bit7io/openpnp-controller/README.md

### Open source PNP controller
Generic controller for a PNP machine with 2 heads, needle/drag tape advance, L&R motors for tape peelers, 1 vibrating feeder, 1 air pump, 2 Y steppers, up looking camera on UART, down looking camera on UART, display on UART and SD card for input.
