bit7io/openpnp-controller/MCU.kicad_sch

## KiCad design MCU.kicad_sch (2024-02-26)

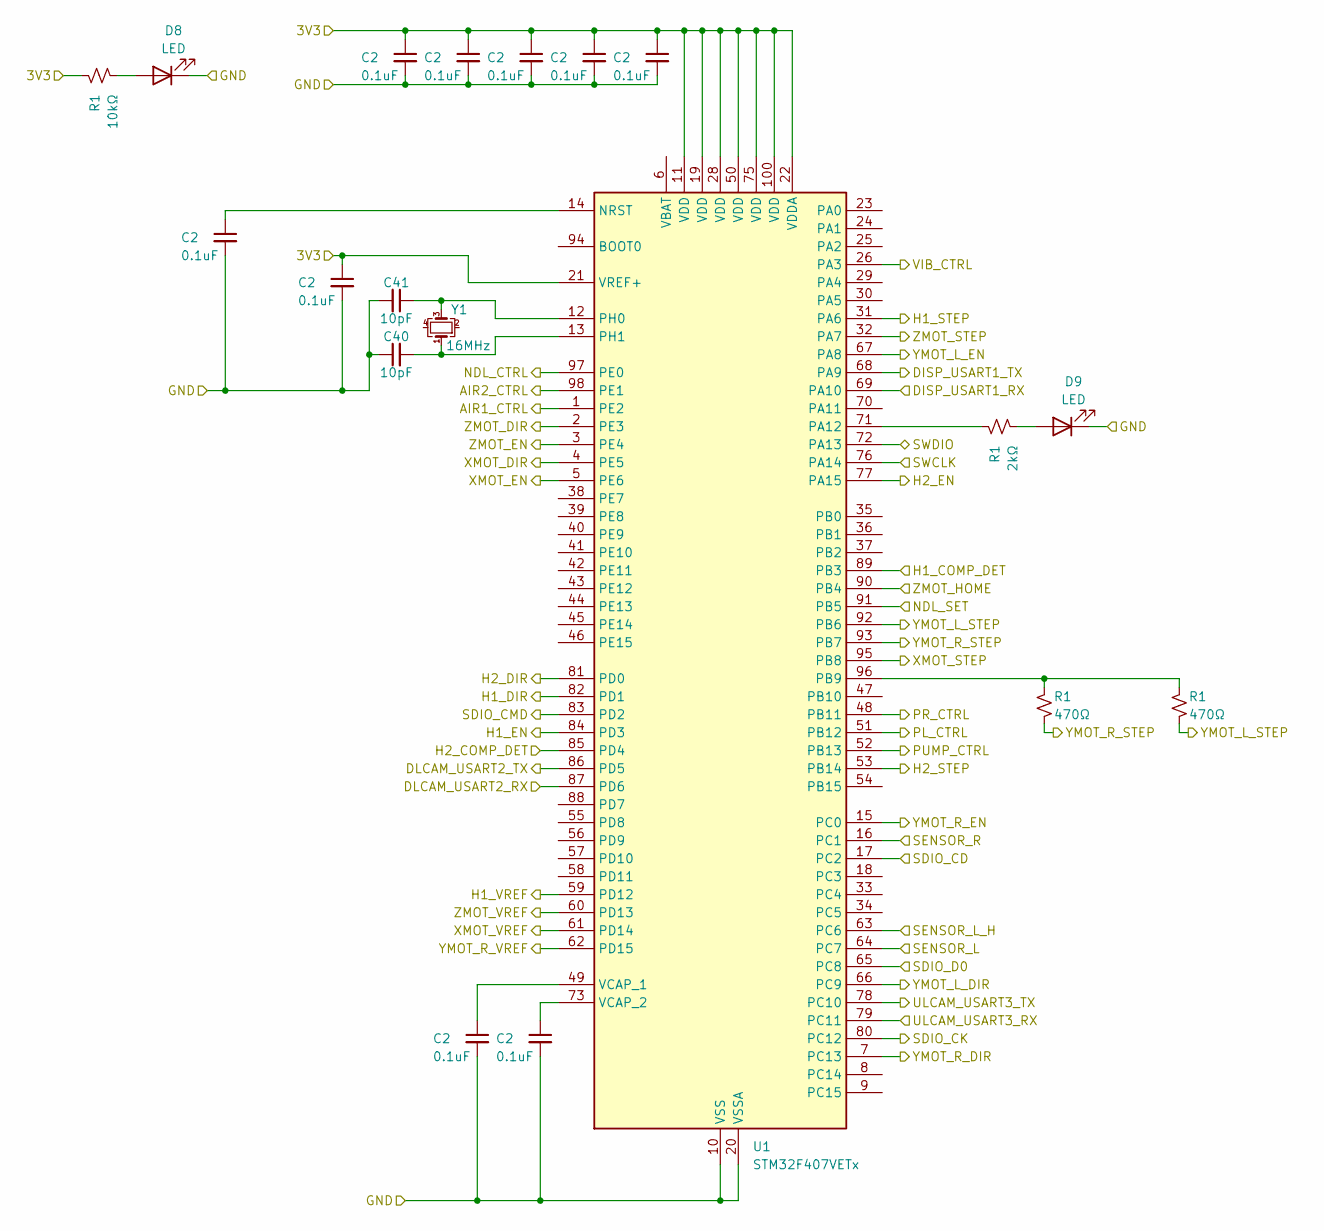
[picture p1: schematic MCU.kicad_sch]

Parts:
C2: 0.1uF
C40, C41: 10pF
D8, D9: LED
R1: 470Ω
U1: STM32F407VETx; LQFP-100_14x14mm_P0.5mm; MPN STM32F407VET6
Y1: 16MHz; MPN RH100-16.000-8-2020-TR

Connections:
3V3: C2.1, R1.1, U1.11 (VDD), U1.19 (VDD), U1.21 (VREF+), U1.22 (VDDA), U1.28 (VDD), U1.50 (VDD), U1.75 (VDD), U1.100 (VDD)
AIR1_CTRL: U1.1 (PE2)
AIR2_CTRL: U1.98 (PE1)
DISP_USART1_RX: U1.69 (PA10)
DISP_USART1_TX: U1.68 (PA9)
DLCAM_USART2_RX: U1.87 (PD6)
DLCAM_USART2_TX: U1.86 (PD5)
GND: C2.2, C40.1, C41.2, D8.1 (K), D9.1 (K), U1.10 (VSS), U1.20 (VSSA), U1.27 (VSS), U1.74 (VSS), U1.99 (VSS)
H1_COMP_DET: U1.89 (PB3)
H1_DIR: U1.82 (PD1)
H1_EN: U1.84 (PD3)
H1_STEP: U1.31 (PA6)
H1_VREF: U1.59 (PD12)
H2_COMP_DET: U1.85 (PD4)
H2_DIR: U1.81 (PD0)
H2_EN: U1.77 (PA15)
H2_STEP: U1.53 (PB14)
NDL_CTRL: U1.97 (PE0)
NDL_SET: U1.91 (PB5)
unnamed: C2.1, U1.14 (NRST), U1.49 (VCAP_1), U1.73 (VCAP_2)
unnamed: C40.2, U1.13 (PH1), Y1.1
unnamed: C41.1, U1.12 (PH0), Y1.3
unnamed: D8.2 (A), R1.2
unnamed: D9.2 (A), R1.2
unnamed: R1.1, U1.71 (PA12)
unnamed: R1.2, U1.96 (PB9)
PL_CTRL: U1.51 (PB12)
PR_CTRL: U1.48 (PB11)
PUMP_CTRL: U1.52 (PB13)
SDIO_CD: U1.17 (PC2)
SDIO_CK: U1.80 (PC12)
SDIO_CMD: U1.83 (PD2)
SDIO_D0: U1.65 (PC8)
SENSOR_L: U1.64 (PC7)
SENSOR_L_H: U1.63 (PC6)
SENSOR_R: U1.16 (PC1)
SWCLK: U1.76 (PA14)
SWDIO: U1.72 (PA13)
ULCAM_USART3_RX: U1.79 (PC11)
ULCAM_USART3_TX: U1.78 (PC10)
VIB_CTRL: U1.26 (PA3)
XMOT_DIR: U1.4 (PE5)
XMOT_EN: U1.5 (PE6)
XMOT_STEP: U1.95 (PB8)
XMOT_VREF: U1.61 (PD14)
YMOT_L_DIR: U1.66 (PC9)
YMOT_L_EN: U1.67 (PA8)
YMOT_L_STEP: R1.1, U1.92 (PB6)
YMOT_R_DIR: U1.7 (PC13)
YMOT_R_EN: U1.15 (PC0)
YMOT_R_STEP: R1.1, U1.93 (PB7)
YMOT_R_VREF: U1.62 (PD15)
ZMOT_DIR: U1.2 (PE3)
ZMOT_EN: U1.3 (PE4)
ZMOT_HOME: U1.90 (PB4)
ZMOT_STEP: U1.32 (PA7)
ZMOT_VREF: U1.60 (PD13)
