bit7io/openpnp-controller/Motors.kicad_sch

## KiCad design Motors.kicad_sch (2024-02-26)

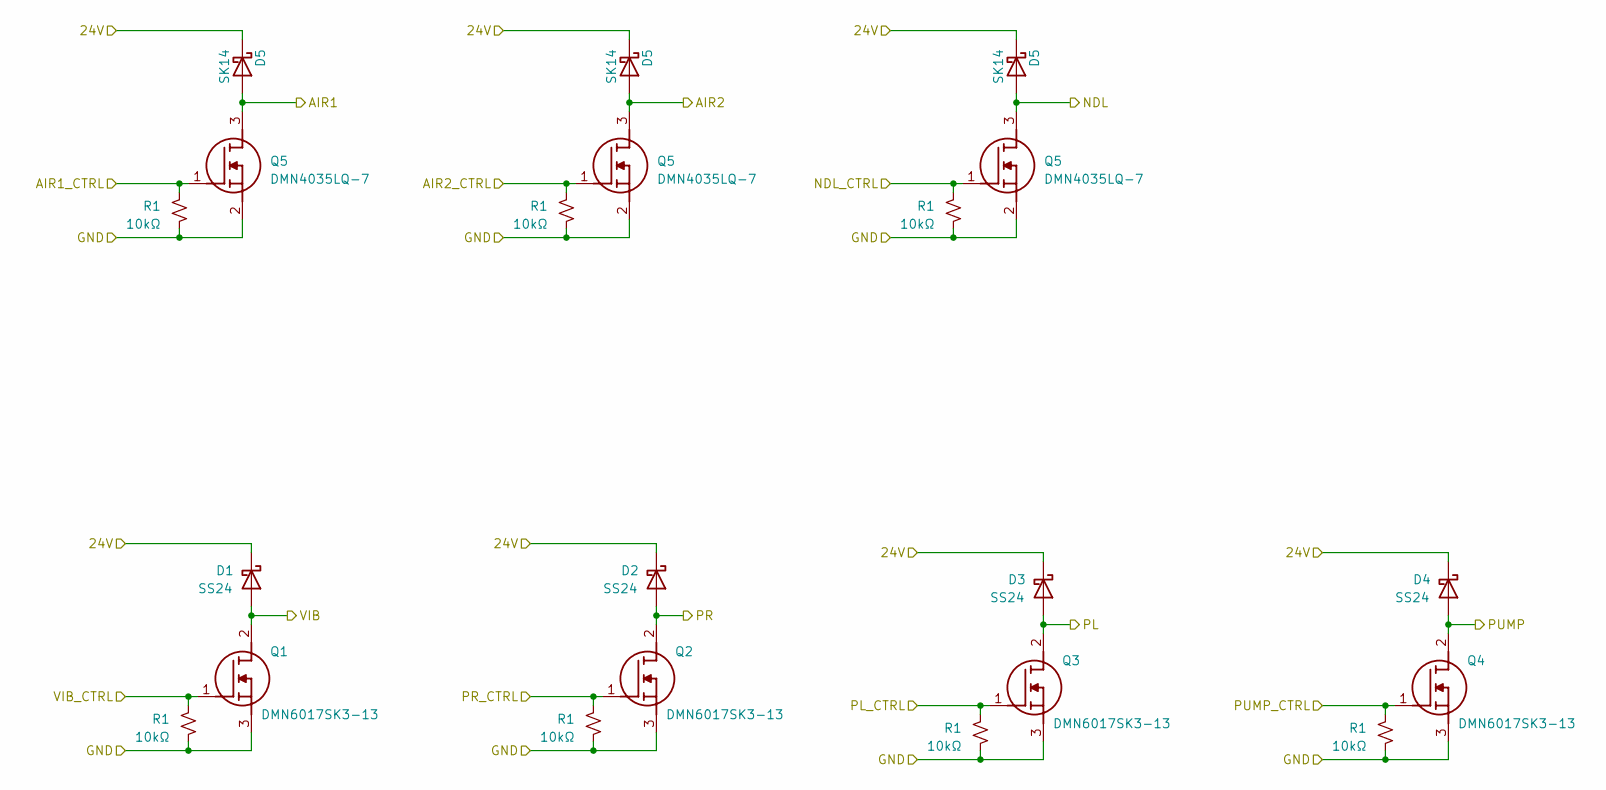
[picture p2: schematic Motors.kicad_sch]

Parts:
D1, D2, D3, D4: SS24
D5: SK14
Q1, Q2, Q3, Q4: DMN6017SK3-13; DMN6017SK313; Mouser Part Number 621-DMN6017SK3-13
Q5: DMN4035LQ-7; SOT96P240X110-3N; Mouser Part Number 621-DMN4035LQ-7
R1: 10kΩ

Connections:
24V: D1.1 (K), D2.1 (K), D3.1 (K), D4.1 (K), D5.1 (K)
AIR1: D5.2 (A), Q5.3 (D)
AIR1_CTRL: Q5.1 (G), R1.1
AIR2: D5.2 (A), Q5.3 (D)
AIR2_CTRL: Q5.1 (G), R1.1
GND: Q1.3 (S), Q2.3 (S), Q3.3 (S), Q4.3 (S), Q5.2 (S), R1.2
NDL: D5.2 (A), Q5.3 (D)
NDL_CTRL: Q5.1 (G), R1.1
PL: D3.2 (A), Q3.2 (D)
PL_CTRL: Q3.1 (G), R1.1
PR: D2.2 (A), Q2.2 (D)
PR_CTRL: Q2.1 (G), R1.1
PUMP: D4.2 (A), Q4.2 (D)
PUMP_CTRL: Q4.1 (G), R1.1
VIB: D1.2 (A), Q1.2 (D)
VIB_CTRL: Q1.1 (G), R1.1
