bit7io/openpnp-controller/Power.kicad_sch

## KiCad design Power.kicad_sch (2024-02-26)

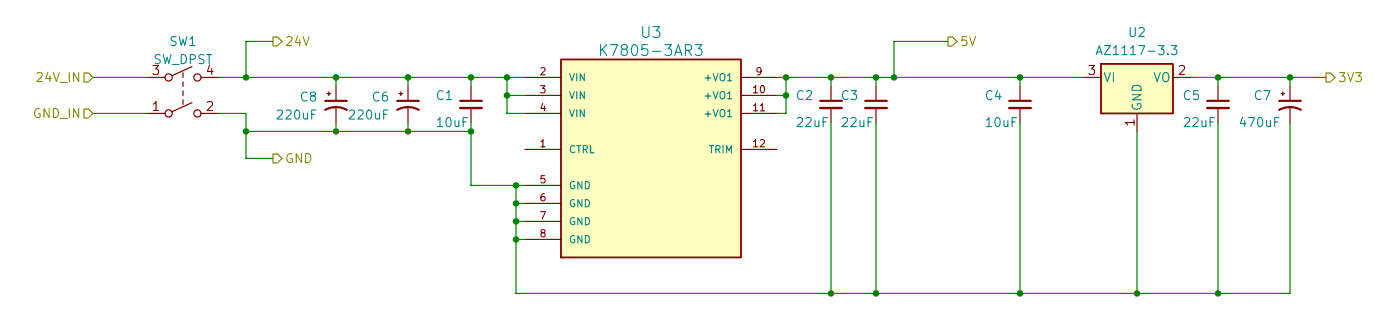
[picture p3: schematic Power.kicad_sch]

Parts:
C1, C4: 10uF
C2, C3, C5: 22uF
C6, C8: 220uF
C7: 470uF
SW1: SW_DPST
U2: AZ1117-3.3
U3: K7805-3AR3; CONV_K7805-3AR3; PARTREV 2021.01.29-A/2

Connections:
3V3: C5.1, C7.1, U2.2 (VO)
5V: C2.1, C3.1, C4.1, U2.3 (VI), U3.9 (+VO1), U3.10 (+VO1), U3.11 (+VO1)
24V: C1.1, C6.1, C8.1, SW1.4, U3.2 (VIN), U3.3 (VIN), U3.4 (VIN)
24V_IN: SW1.3
GND: C1.2, C2.2, C3.2, C4.2, C5.2, C6.2, C7.2, C8.2, SW1.2, U2.1 (GND), U3.5 (GND), U3.6 (GND), U3.7 (GND), U3.8 (GND)
GND_IN: SW1.1
