bit7io/openpnp-controller/openpnp-controller-1.0.kicad_sch

## KiCad design openpnp-controller-1.0.kicad_sch (2024-02-26)

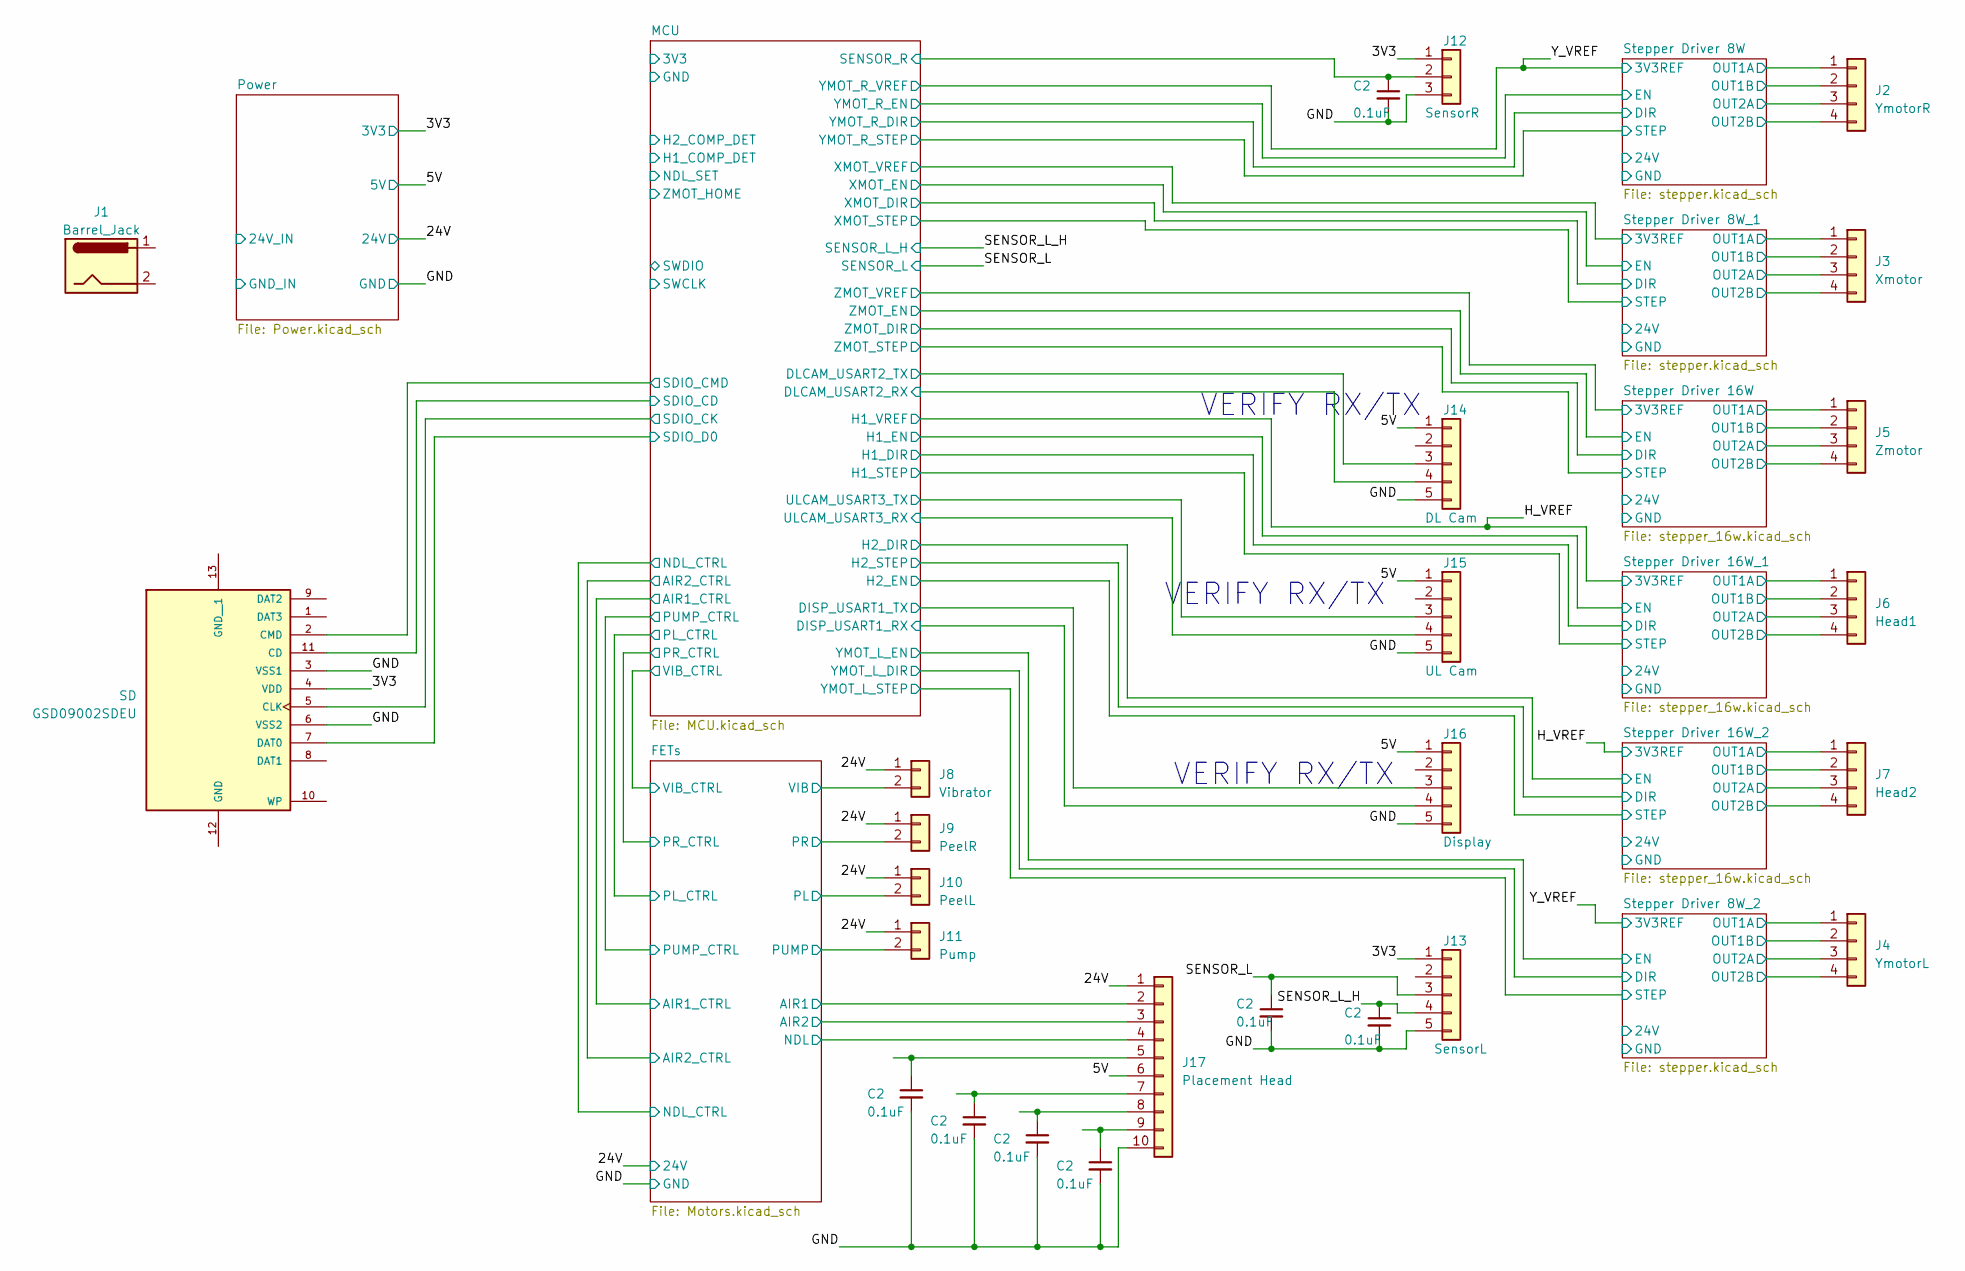
[picture p4: schematic openpnp-controller-1.0.kicad_sch]

Parts:
C2: 0.1uF
J1: Barrel_Jack
J2: YmotorR
J3: Xmotor
J4: YmotorL
J5: Zmotor
J6: Head1
J7: Head2
J8: Vibrator
J9: PeelR
J10: PeelL
J11: Pump
J12: SensorR
J13: SensorL
J14: DL Cam
J15: UL Cam
J16: Display
J17: Placement Head
SD: GSD09002SDEU; AMPHENOL_GSD09002SDEU; PARTREV A

Connections:
3V3: J12.1, J13.1, SD.4 (VDD)
5V: J14.1, J15.1, J16.1, J17.6
24V: J8.1, J9.1, J10.1, J11.1, J17.1
AIR1: J17.2
AIR2: J17.3
DISP_USART1_RX: J16.4
DISP_USART1_TX: J16.3
DLCAM_USART2_RX: J14.4
DLCAM_USART2_TX: J14.3
GND: C2.2, J12.3, J13.5, J14.5, J15.5, J16.5, J17.10, SD.3 (VSS1), SD.6 (VSS2)
NDL: J17.4
unnamed: C2.1, J17.5, J17.7, J17.8, J17.9
OUT1A: J2.1, J3.1, J4.1, J5.1, J6.1, J7.1
OUT1B: J2.2, J3.2, J4.2, J5.2, J6.2, J7.2
OUT2A: J2.3, J3.3, J4.3, J5.3, J6.3, J7.3
OUT2B: J2.4, J3.4, J4.4, J5.4, J6.4, J7.4
PL: J10.2
PR: J9.2
PUMP: J11.2
SDIO_CD: SD.11 (CD)
SDIO_CK: SD.5 (CLK)
SDIO_CMD: SD.2 (CMD)
SDIO_D0: SD.7 (DAT0)
SENSOR_L: C2.1, J13.3
SENSOR_L_H: C2.1, J13.4
SENSOR_R: C2.1, J12.2
ULCAM_USART3_RX: J15.4
ULCAM_USART3_TX: J15.3
VIB: J8.2

Notes on the sheet:
VERIFY RX/TX
