bit7io/openpnp-controller/stepper.kicad_sch

## KiCad design stepper.kicad_sch (2024-02-26)

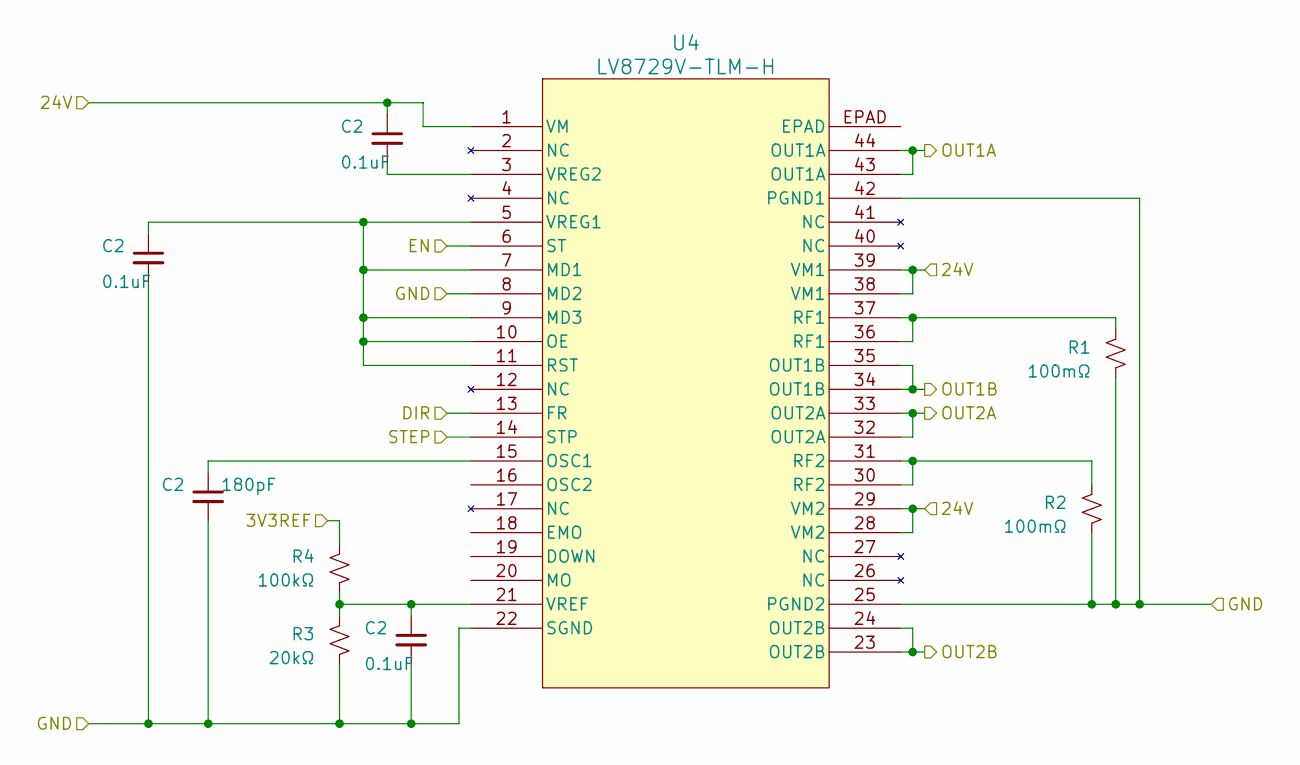
[picture p5: schematic stepper.kicad_sch]

Parts:
C2: 180pF
R1, R2: 100mΩ; MPN RLC73PW2HR10FTE
R3: 20kΩ
R4: 100kΩ
U4: LV8729V-TLM-H; SSOP44K_5P6X15P45_ONS

Connections:
3V3REF: R4.1
24V: C2.1, U4.1 (VM), U4.28 (VM2), U4.29 (VM2), U4.38 (VM1), U4.39 (VM1)
DIR: U4.13 (FR)
EN: U4.6 (ST)
GND: C2.2, R1.2, R2.2, R3.2, U4.8 (MD2), U4.22 (SGND), U4.25 (PGND2), U4.42 (PGND1)
unnamed: C2.1, R3.1, R4.2, U4.5 (VREG1), U4.7 (MD1), U4.9 (MD3), U4.10 (OE), U4.11 (RST), U4.15 (OSC1), U4.21 (VREF)
unnamed: C2.2, U4.3 (VREG2)
unnamed: R1.1, U4.36 (RF1), U4.37 (RF1)
unnamed: R2.1, U4.30 (RF2), U4.31 (RF2)
OUT1A: U4.43 (OUT1A), U4.44 (OUT1A)
OUT1B: U4.34 (OUT1B), U4.35 (OUT1B)
OUT2A: U4.32 (OUT2A), U4.33 (OUT2A)
OUT2B: U4.23 (OUT2B), U4.24 (OUT2B)
STEP: U4.14 (STP)
